Dylancouzon/l6-robot/docs/README.md

# Documentation

Choose the shortest guide that matches what you are trying to do.

## First Steps

The printable enclosure does not include the electronics. If you want to build the complete robot, check the hardware requirements before you print anything.

| Guide | Use It When |
|---|---|
| [Get Started](getting-started.md) | You want to run the software with a computer and webcam. |
| [Hardware](hardware-parts.md) | You need the parts and material requirements for the Jetson robot. |
| [Build Your Own Robot](build.md) | You want the complete Jetson, enclosure, phone, and headless setup. |
| [Understand the Architecture](architecture.md) | You finished the course and want to follow the implementation. |

## Focused Guides

| Guide | Covers |
|---|---|
| [Print and Assemble the Enclosure](hardware.md) | Camera fit, print settings, and assembly. |
| [Calibrate the Camera](calibration.md) | Recognition thresholds, detection settings, and command-line options. |
| [Use a Phone](phone.md) | Network access, microphone permissions, and the HTTPS certificate. |
| [Set Up a Headless Jetson](appliance.md) | Automatic startup, the robot's Wi-Fi network, and maintenance. |

The top-level [README](../README.md) is the project overview. Configuration values are documented beside their defaults in [`.env.example`](../.env.example).
