Dylancouzon/l6-robot/docs/hardware-parts.md

# Hardware

The printable files contain the enclosure only. To build the complete robot, gather every item in the following table before you print the enclosure.

| Item | What You Need |
|---|---|
| Computer | Jetson Orin Nano Super 8 GB developer kit with its power supply |
| Storage | 256 GB or larger M.2 2280 NVMe solid-state drive (SSD) |
| Camera | 37 × 37 mm USB Video Class (UVC) camera board with a lens near 100° |
| Interface | Phone or tablet with Wi-Fi and a microphone |
| Filament | About 300 g of PLA in three colors |
| Assembly supplies | One zip tie and a drop of glue |

You also need access to a 3D printer with a build area of at least 177 × 176 mm. The repository provides the ready-to-print files and software.

## Check Camera Compatibility

The enclosure was designed around the Arducam IMX291 (B0200). A different camera must meet all three measurements:

- Board: 37 × 37 mm and 1.4 to 1.8 mm thick, with connectors on the back.
- Lens length: no more than 27 mm from the front of the board when focused fully inward.
- Lens width: no part around the barrel wider than 26.5 mm.

Check the manufacturer's dimensions or measure the camera before printing. The glued visor makes a later camera change difficult.

After you have the parts, follow [Build Your Own Robot](build.md) for the complete setup sequence or go directly to [Print and Assemble the Enclosure](hardware.md).
