Dylancouzon/l6-robot/hardware/eye_visor.stl

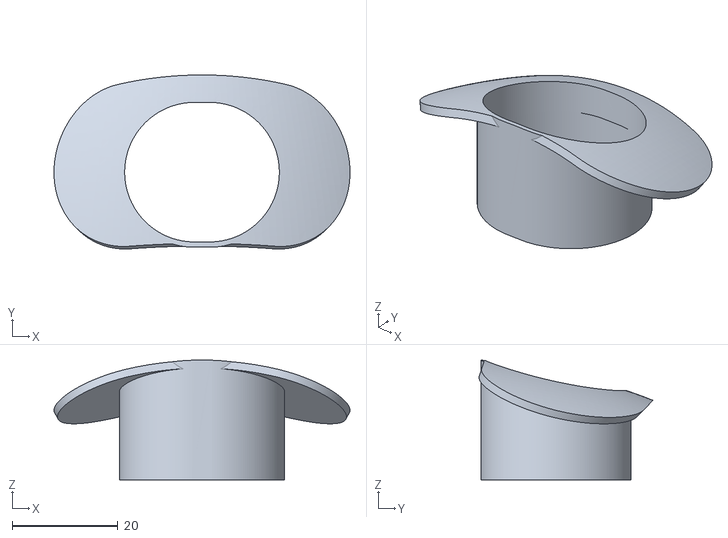
[picture p6: CAD file, 2026-08-19]
hardware/eye_visor.stl
56.0 x 32.9 x 22.7
