Dylancouzon/l6-robot/hardware/antenna_tip.stl

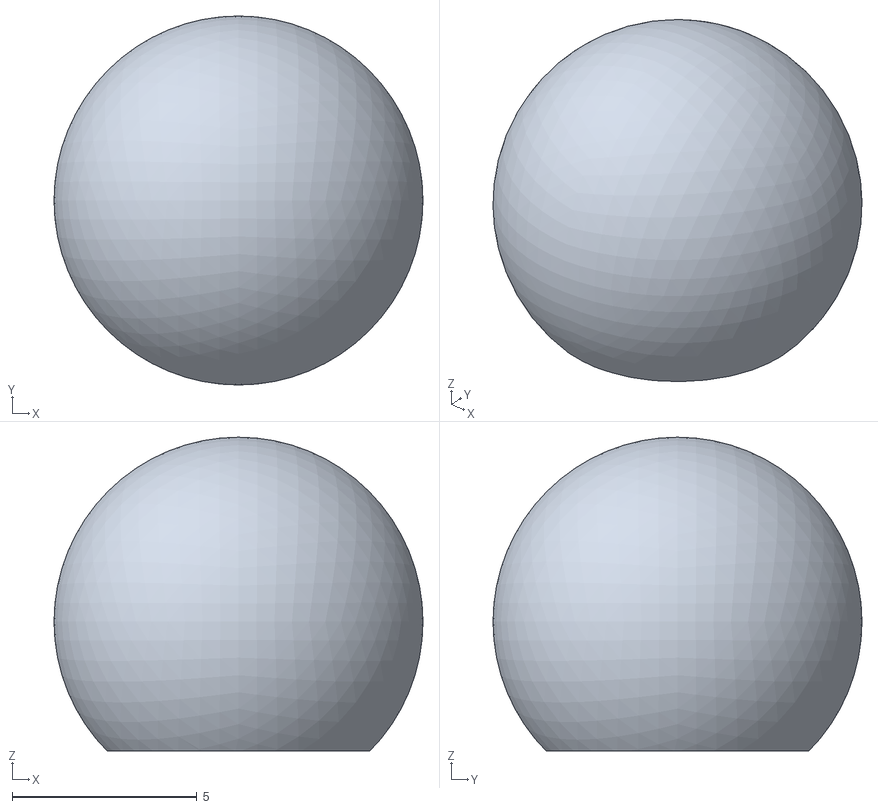
[picture p7: CAD file, 2026-08-19]
hardware/antenna_tip.stl
10.0 x 10.0 x 8.50
