Dylancouzon/l6-robot/hardware/shell.stl

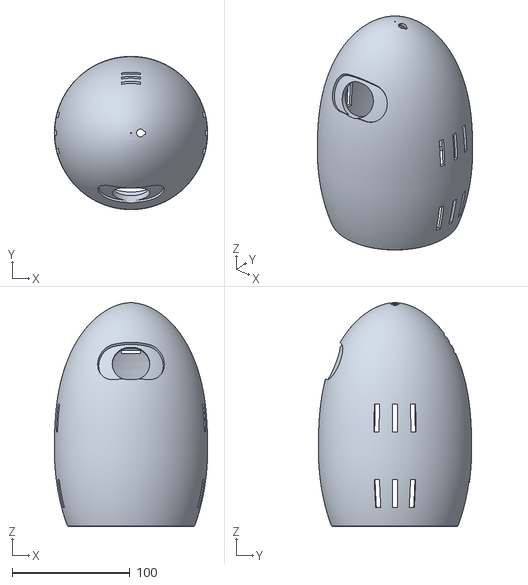
[picture p8: CAD file, 2026-08-19]
hardware/shell.stl
130.0 x 130.0 x 190.0
