Dylancouzon/l6-robot/hardware/antenna.stl

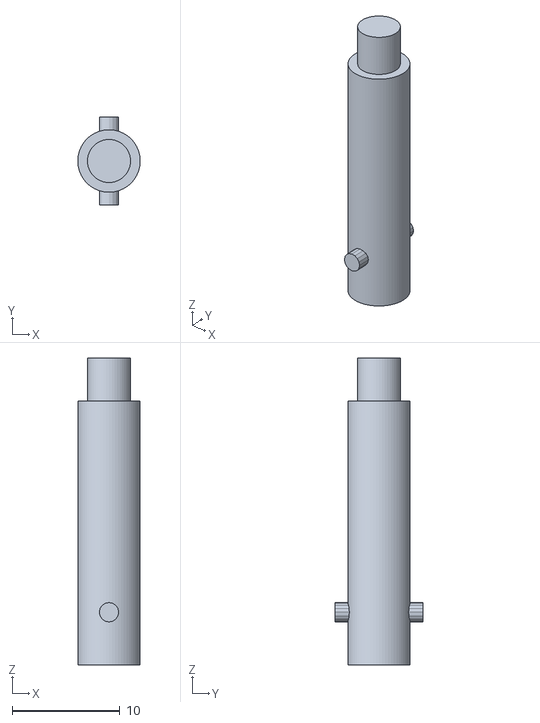
[picture p9: CAD file, 2026-08-19]
hardware/antenna.stl
5.80 x 8.20 x 28.5
