Dylancouzon/l6-robot/hardware/keel.stl

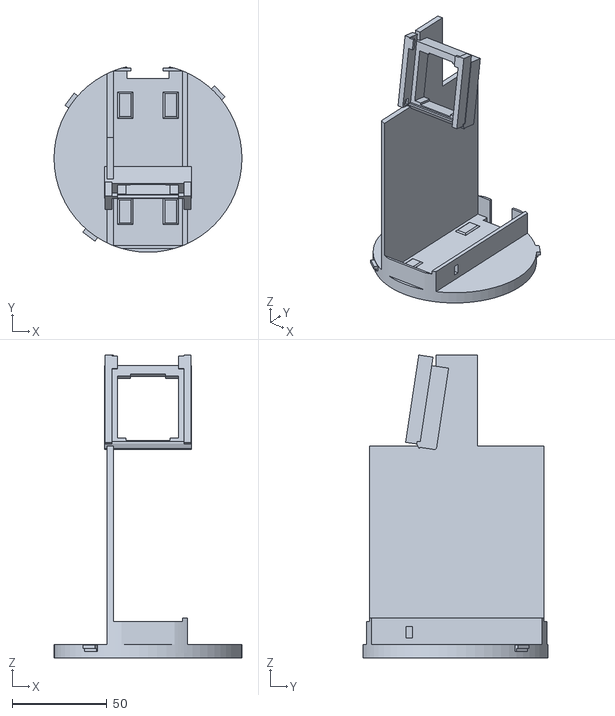
[picture p10: CAD file, 2026-08-19]
hardware/keel.stl
99.0 x 97.7 x 159.6
