Dylancouzon/l6-robot/hardware/charcoal_plate.3mf

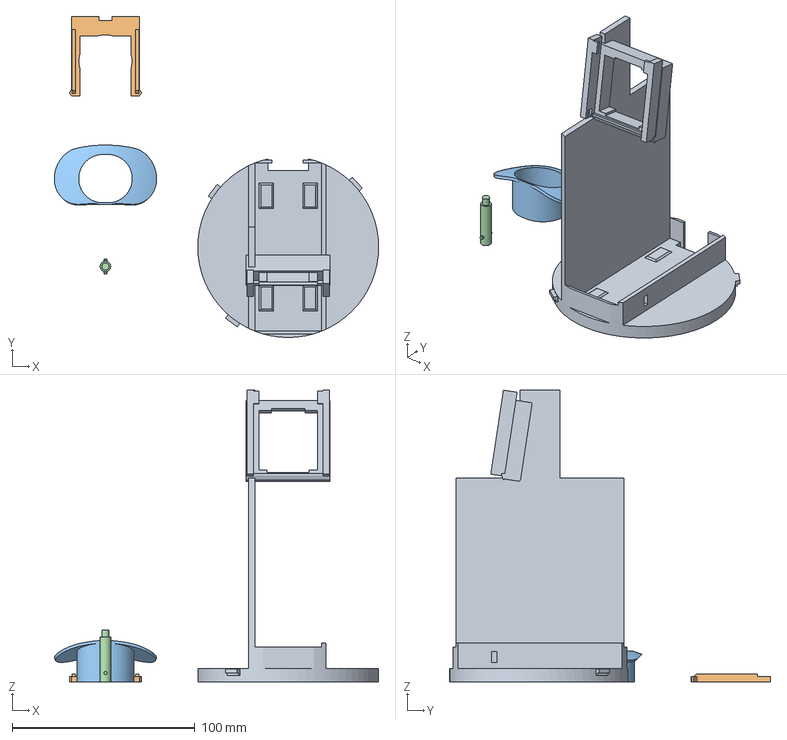
[picture p11: CAD file, 2026-08-19]
hardware/charcoal_plate.3mf
177.5 x 175.7 x 159.6 mm
l6b1_keel
l6b1_camera_clamp
l6b1_eye_visor
l6b1_antenna
