Dylancouzon/l6-robot/hardware/camera_clamp.stl

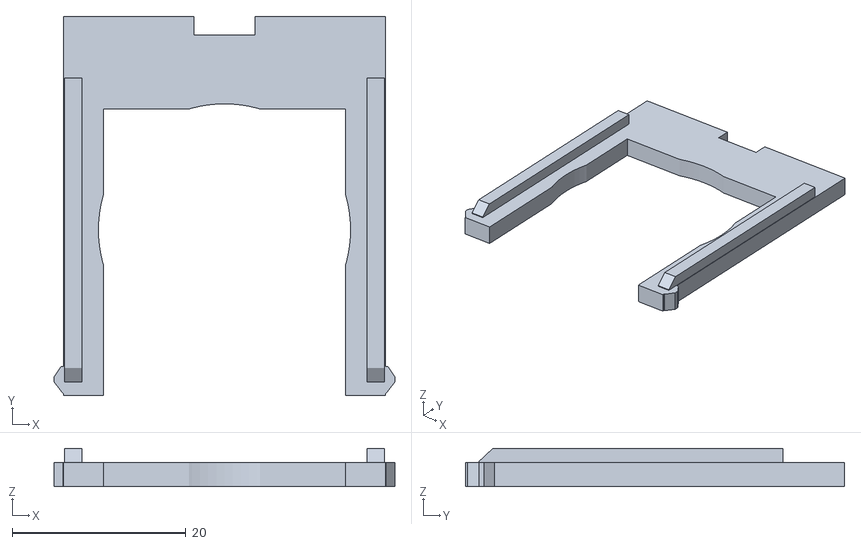
[picture p12: CAD file, 2026-08-19]
hardware/camera_clamp.stl
39.2 x 43.6 x 4.40
