Dylancouzon/l6-robot/(list of files, cad)

Other CAD files:
hardware/white_plate.3mf
hardware/red_plate.3mf
