Dylancouzon/l6-robot/testdata/hardhat_1.jpg

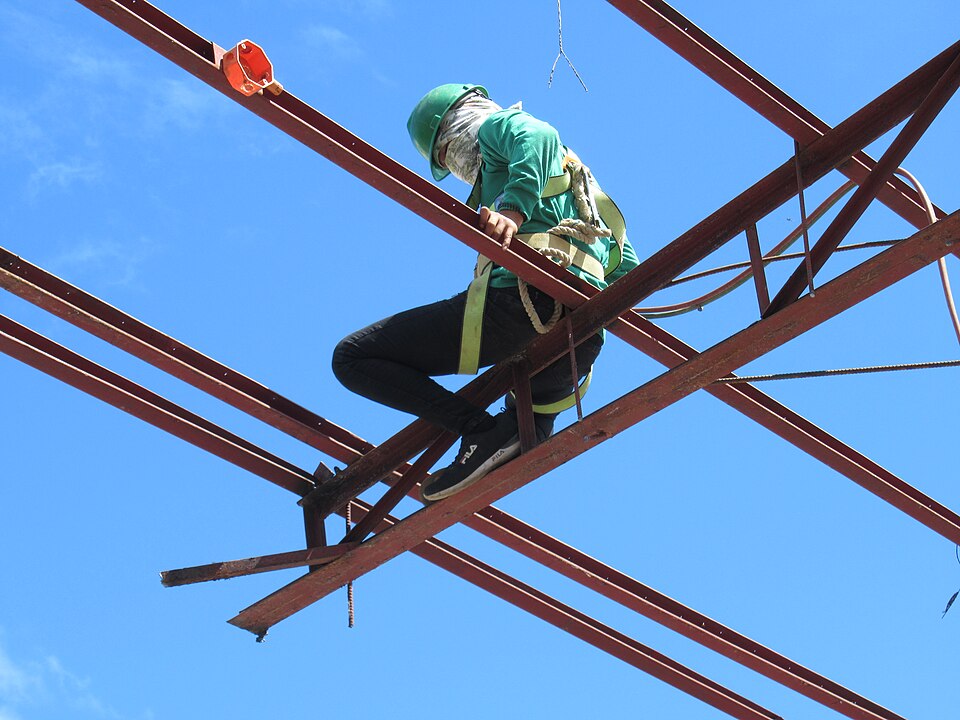
testdata/hardhat_1.jpg
