Dylancouzon/l6-robot/testdata/rubberduck_1.jpg

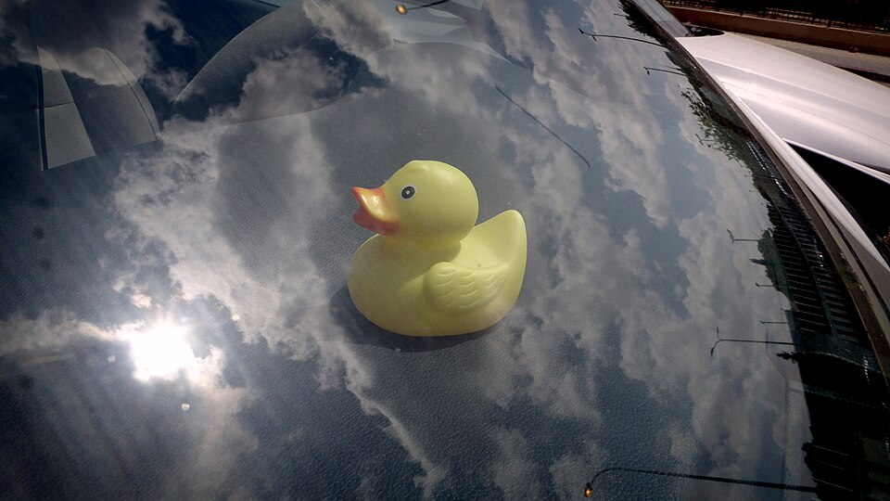
testdata/rubberduck_1.jpg
