Dylancouzon/l6-robot/testdata/rubberduck_3.jpg

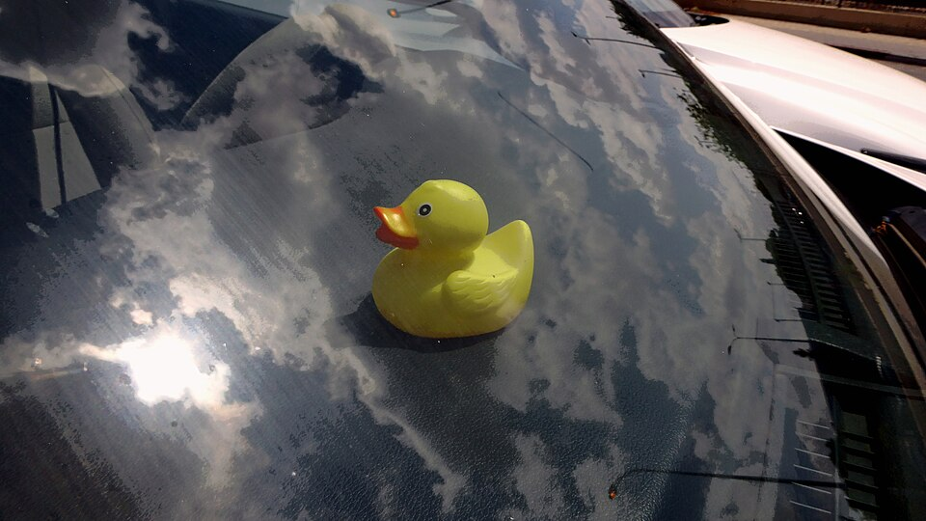
testdata/rubberduck_3.jpg
