Dylancouzon/l6-robot/testdata/vase_1.jpg

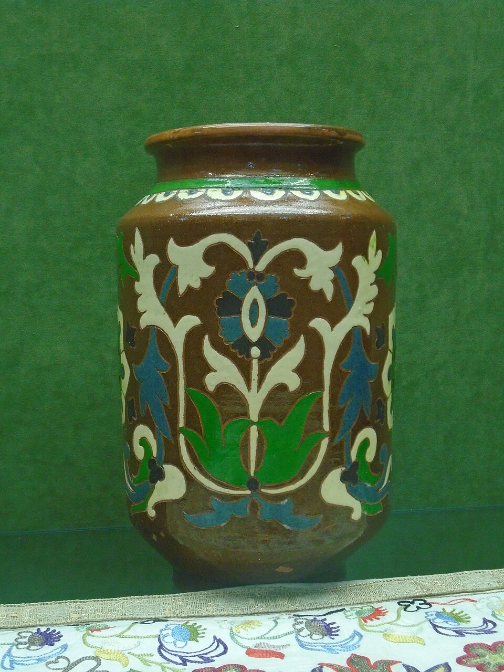
testdata/vase_1.jpg
