Dylancouzon/l6-robot/testdata/vase_2.jpg

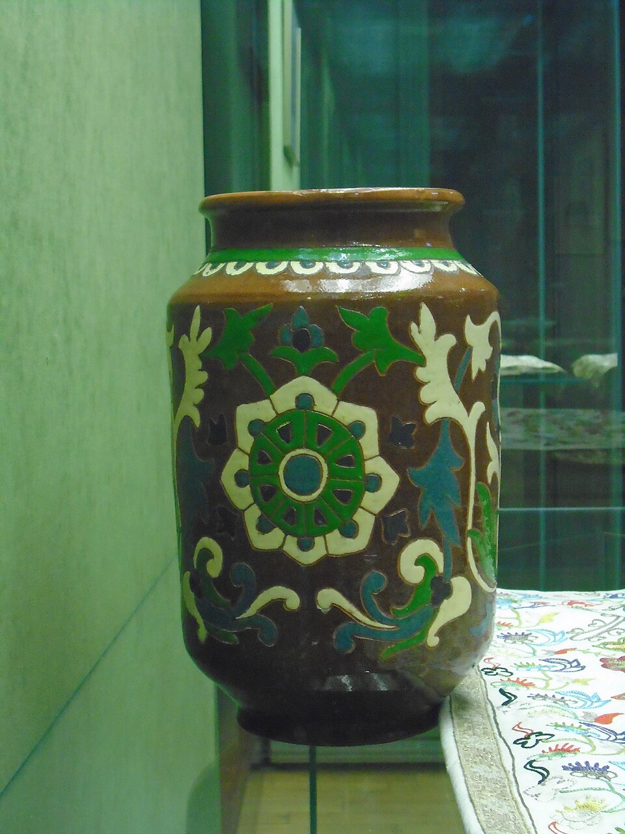
testdata/vase_2.jpg
