Dylancouzon/l6-robot/testdata/vase_3.jpg

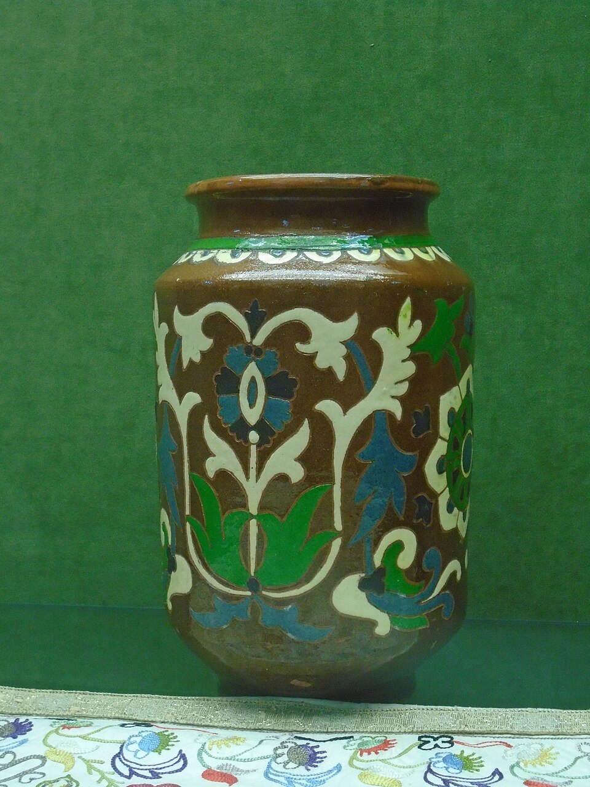
testdata/vase_3.jpg
