Dylancouzon/l6-robot/(commit log)

2026-07-16 Switch mic capture to sounddevice, splash progress
2026-07-16 Verify Edge aarch64 wheel in Jetson checklist
2026-07-16 add BOM, prep for Jetson integration
2026-07-17 Tighten BOM, improve wording
2026-07-17 BOM nits
2026-08-12 Enable CUDA detection on Jetson
2026-08-12 Load only the camera-loop encoder at startup
    The robot became unusable on a Jetson Orin Nano 8 GB, updating the view
    roughly once every 15 seconds. The cause was startup memory, not CUDA:
    warm_up() eagerly built all four ONNX encoders, and ONNX Runtime gives each
    session one spinning thread per core. That reached 3.3 GB and 78 threads
    before the camera opened, leaving ~280 MB free and pushing 2 GB of the
    process into swap, so every teach/ask paged it back in.
    Keeping Whisper resident also bought little: transcription costs ~6 s
    regardless, so residency saved ~3 s of load time for 1.7 GB.
    - warm_up() now loads only the CLIP vision encoder, the one model the camera
    loop uses per frame. The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
2026-08-12 Calibrate the recognition threshold per camera
    Teaching one object made almost everything in frame match it at 0.80-0.88,
    while the true object sat above 0.90.
    The Qdrant layer is fine: stored image vectors have L2 norm 1.0 (Qdrant
    pre-normalizes on upsert for Cosine), shard scores equal hand-computed numpy
    cosine to 1e-7, and the named vectors are correctly wired. The cause is that
    CLIP cosine similarity has a high floor -- two unrelated crops from the same
    camera routinely score 0.75-0.85 -- and the 0.80 threshold came from a harness
    that never exercised the live crop pipeline.
    verify_scores.py cropped large studio photos with no segmentation mask; the
    app masks and feeds crops as small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
2026-08-12 Take button work off the frame pump and steady the focus
    Two operator-visible symptoms on the Jetson: the feed stuttered when
    FORGET or TEACH was pressed, and the single UNKNOWN box hopped between
    objects fast enough that teaching the intended one was a race.
    The stutter was work sitting on the thread that must never block -- the
    one doing cap.read(), composing the view and encoding the streamed JPEG:
    - Key handling ran inline in _loop. FORGET scrolls up to 10k points,
    deletes and flushes; REBOOT reopens the shard. Both also waited on the
    lock the detect thread holds for a whole YOLO pass. Moved to _key_loop
    on its own thread; _loop now captures and renders and takes no lock.
    - Teach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
2026-08-12 Run headless on its own Wi-Fi, starting at boot
    The demo unit goes in a case with no keyboard, screen, or peripherals, and
    demos in rooms with no usable network. Apply power and it now boots into the
    robot on its own access point.
    `deploy/l6-robot.service` starts it at boot and restarts it on death;
    `deploy/headless-setup.sh` installs the unit, builds the NetworkManager AP
    profile, fills the model cache while there is still internet, and turns the
    desktop off (~1.5 GB on an 8 GB board). The Wi-Fi block runs last, because
    converting the radio kills any ssh session arriving over it.
    Two real bugs surfaced doing this, both fixed here rather than papered over
    in the unit:
    - FastEmbed was cach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
2026-08-12 Document how to get into the robot when it is headless
    The unit has no keyboard, screen, or peripherals, and often no network it can
    rely on, so "how do I get a shell on it" stopped being obvious.
    Three independent routes, all verified on the unit. Your LAN, with the robot
    wired to the router and you on its Wi-Fi — the best one, because the robot then
    has internet and its hotspot shares that internet with your phone. The robot's
    own hotspot, which works anywhere but has no uplink, so Claude Code will not run
    over it. And the USB-C debug port at a fixed 192.168.55.1, which needs no
    network, router, or DNS at all. The same cable carries a serial console on
    ttyGS0, so it degrades to a workin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
2026-08-12 Make the appliance's feed and voice path fit its own Wi-Fi
    Over the robot's hotspot the feed ran slow and arrived 5+ s late, every
    action seemed to freeze for seconds, and teaching by voice returned
    nonsense labels. None of it was the headless setup: measured on loopback,
    no action stalls the frame pump by more than 149 ms.
    The feed sent 60% duplicate bytes. /stream pushed on a fixed 0.04 s tick
    while the pump renders at the camera's 10 fps: 171 frames over 7 s, 69
    unique, 37 Mbps. _publish now stamps each composed JPEG and stores one
    atomic (seq, bytes) tuple; the handler sends only on a change and always
    takes the newest, so a client that falls behind loses frames instead of
    accumulating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
2026-08-12 Make the memory panel HTML so it fits a phone
    The panel was pixels drawn into the video: cv2.putText at a fixed 480 px,
    hstacked onto the feed and re-encoded ten times a second. On a phone in
    portrait the browser contains the 2.44:1 composite into ~160 pt of height,
    which renders the panel about 100 pt wide — unreadable, and unfixable by
    any amount of font tuning. Hence the "rotate to landscape" nag the page
    used to carry, which was really a bug report.
    /stream now carries the annotated feed alone and the page polls /state
    (JSON, 4 Hz), rendering the panel as DOM: it lays out for the screen it
    lands on, in portrait as well as landscape. Two small endpoints support
    it — /thumb?f=NAME for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
2026-08-12 Keep a track alive through a dropout, and hold focus steadier
    Recognized objects came and went on a static scene, and teaching seemed to
    freeze. Neither was the recognition threshold and neither was new.
    The cause was DEAD_SECONDS = 1.5. A real object's detector confidence swings
    across DETECT_CONF: the microphone measured 0.34-0.91, and absent altogether on
    some frames, so dropouts past a second are routine. At 1.5 s the Track was
    destroyed, taking label, note, thumb, vec and last_query with it, and the object
    came back a stranger -- nothing on screen for STABLE_FRAMES passes, then a fresh
    embed, then green again. The shard counted it: 866 sighting thumbs, and in one
    25-minute window 57 Tr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
2026-08-12 Cut first-teach latency, unify label casing, re-arm the swap backstop
    Review round on "teach is slow to register, recognition okay but not
    great", measured on the live box and shard before anything moved:
    - Teach's steady 6 s is whisper-base on CPU — the floor (ORT here is the
    CPU-only build); documented, not chased. The first action of a session
    paid ~7 s of model loads after release; the phone path now warms them
    under the button hold, behind a lock, because lru_cache does not
    serialize a cache miss. The laptop path deliberately does not warm at
    press: a cold load's 1.4-1.6 s GIL holds starve record_wav's 100 ms
    reads and chop the audio (caught by adversarial review), and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
2026-08-13 Add a memory tab, and let the robot recognize people
    FORGET could not be aimed. It acted on whatever held the box at the
    instant of the press, and focus moves between deciding to press and
    pressing, so the object that got deleted was not always the one the
    operator was looking at. Deleting now happens in a MEMORY tab, where you
    pick the object off a list and see its picture first. The button took
    FORGET's slot -- still four buttons -- and the F key stays for filming.
    The tab lists every taught object with its picture, its sighting count
    and its taught views (tap the picture to walk them), pages in on scroll,
    and lists what IGNORE dismissed so it can be undone. Two edits that used
    to require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
2026-08-13 Trim the handoff notes to what a future session can act on
    The two "Verified" subsections were test transcripts -- 212 points
    renamed, a score of 0.753, `view 1 of 2` becoming `2 of 2` -- which
    record that something was checked without telling the next session
    anything it can use. Replaced with the part that is reusable: the method
    (drive the endpoints against a copy of the shard, teach without a mic
    via /listen + /audio) and the browser harness worth rebuilding, plus its
    two traps -- firefox screenshots on the load event, so hold that open or
    you photograph a half-laid-out page, and drive the probe against a stub,
    never the live service.
    Also stops describing the scene picture's whole-fram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
2026-08-13 Answer recall from the text space, add SET LOCATION, and unblock the tab
    Three rounds, all measured on the live unit before anything moved:
    - The reported "system slowed down" was the hotspot NAT-sharing Ethernet
    to a joined laptop — documentation, not code (README, twice). The review
    it prompted found the real code cost: /memories and /ignored waited
    0.8-1.6 s behind the detect thread's YOLO lock for half-millisecond
    reads. Memory now serializes its own shard access and the ignore dict is
    copy-on-write, so tab reads answer in ~5 ms with the app lock held.
    - SET LOCATION in the memory tab edits the place stamped on new memories
    (POST /where, persisted in edge-data/where.txt a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
2026-08-13 Persist IGNORE by appearance, show sightings in the tab, document the mic prompt
    Three phone reports. Ignored objects died with the session because only a
    track id was stored, and ids restart every run — a dismissal is now a
    kind="ignored" point (vector + picture) in the shard, and an unknown whose
    requery matches no taught view is re-suppressed against those points at the
    same 0.90 bar. Taught always beats ignored, so a degenerate ignored crop can
    at worst hide unknown clutter; the tab lists every dismissal with TRACK
    AGAIN, which deletes the point and lifts its live blocks (pids travel as
    strings — the 2^53 trap). The memory tab's card now tap-cycles taught views
    then recent sightings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
2026-08-13 Show the maybe band in orange, and route the iOS cert install through Safari
    A nearest-taught score within 0.05 under the bar now draws an orange box
    and panel state saying "hat? 0.87" instead of a bare UNKNOWN. Display only,
    deliberately: a guessed track is still unlabeled — still the teach target,
    writes no sighting, can't be forgotten, still checked against the ignore
    list — so the measured refusal to act at 0.88 stands. A hat in orange says
    "teach this angle"; a mirror in orange shows what the bar keeps out.
    The every-press mic prompt was Chrome on iOS with the cert untrusted:
    Chrome can't install profiles, so the README now says to download
    /cert.crt in Safari, after which the trus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
2026-08-13 One count over the card cycle, tap-to-confirm on a guess, DROP on sightings
    Three same-day reports from driving the maybe band and the sightings cycle.
    The card caption runs one combined count ("3 of 10 · seen") instead of two
    lists inside one cycle. Tapping the orange "dylan?" panel label now teaches
    that crop under that name — the page sends the label it displayed and the
    server re-verifies it against the live guess before acting (the FORGET
    lesson), then labels the track in place so the box turns teal on the tap
    and a double-tap is a no-op; encoders warm outside the lock like the voice
    path. DROP THIS VIEW works on sightings too, through the same verified
    door: taught ids first (last-v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
2026-08-13 Drop a sighting's whole burst, so the delete is visible
    "Dropping a view doesn't work. Stays at the same count" — the delete
    worked, invisibly. The tab and recall show burst-collapsed rows (one photo
    stands for every sighting within SIGHTING_APART of it), so deleting only
    the shown point promoted a near-identical frame from the same burst into
    the same slot: measured on a live-shard copy, hat's dropped row came back
    151 s older and looked identical. The unit of deletion is now the unit of
    display: forget_sighting_burst deletes the shown row's burst, bounded by
    the point's own label so a stale page can never delete another object's
    photos. Same scenario now removes 4 photos and surfaces an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
2026-08-13 Uncap the card's occasion list, so the counter shrinks when you drop
    The sightings list was capped at the newest 8 occasions, and an object
    with more than 8 made DROP look broken all over again: drop one of 40 and
    the 9th slides into the slot — the counter never moves. Operator caught it
    on hat within a day of the burst fix. The list is what DROP works through,
    so it now shows every distinct occasion; the counter is real and shrinks
    on every drop. Cheap on real data: the whole live shard puts 66 occasion
    rows in one /memories page, and pictures load only when shown.
2026-08-13 Name Whisper's language, and stop drawing a dismissed object
    Teaching was slow for a reason this file had twice ruled out. onnx-asr's
    Whisper here is the beam-search export — one graph holding the encoder and
    the decoder — and letting it detect the language runs that whole graph a
    second time. Naming it halves every teach and every ask, byte-identical
    transcript; it also stops the mis-detection that stored an English teach as
    "делан". Whisper gets its own thread count too: it is the only model a human
    waits on and it never runs beside another. Measured through the live app,
    release to answer, warm session: ~6 s before, 2.82 s with the language named,
    1.90 s at four threads — and t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
2026-08-13 Cut CLAUDE.md from 2155 lines to 671
    It was organized as sixteen rounds of narrative, newest last, which meant
    every session read the story of how each bug was found in order to reach the
    fact it left behind. This keeps the facts and drops the stories: the
    constraints, the constants and what each one decides, the traps that would
    otherwise be reintroduced, the measurements worth trusting, and the questions
    already settled. Reorganized by subsystem — recognition, detection, voice,
    memory, threads and the page, the appliance — so a session touching one area
    reads that area.
    Nothing load-bearing is gone. Every refused change keeps its measurement (0.88
    above all), every trap keeps the reas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
2026-08-19 Add hardware
    [l6b1_antenna.stl, l6b1_antenna_tip.stl, l6b1_camera_clamp.stl, l6b1_charcoal_plate.3mf, l6b1_eye_visor.stl, l6b1_keel.stl, l6b1_red_plate.3mf, l6b1_shell.stl]
2026-08-19 Reorganize into brain and device, tighten docs
2026-08-20 Half-turn every camera frame, because the chassis mounts it upside down
    CAMERA_ROTATE in .env, applied in LiveApp._loop right after cap.read(). That
    is the one place the camera enters the app, so the detector, the crops that get
    embedded, the scene pictures and the streamed view all agree about which way is
    up; rotating any deeper would let the feed and the memories disagree. 0.77 ms
    median on a 1280x720 frame against a 103 ms cap.read().
    Default 0, since a student's camera sits the right way up. The unit's own .env
    says 180. Only those two values are accepted and anything else exits at
    startup: a quarter turn swaps the frame's width and height, which the capture
    size, the page's video box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
2026-08-20 Crop the lens rim off every camera frame
2026-08-24 Run the detector at half precision on CUDA
    quantize_for(device) returns 16 on CUDA and None everywhere else, and both
    model calls in Detector ask it -- the warm-up predict as well as the track
    pass, so the first real frame is not the one that pays for a different
    precision. 167.7 -> 104.4 ms per tracked frame, p90 170.1 -> 105.8, whole
    detect pass 178.1 -> 112, CUDA peak 346 -> 181 MB. Measured over 70 frames of
    one fixed capture, so re-measure the same way rather than against a live scene.
    The detections do not move: same proposal count and the same stable tracks on
    every frame, boxes matching the fp32 run at median IoU 0.995. The scores do,
    in the third decimal, because a box shifted by h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
2026-09-01 rename print files
    [antenna.stl, antenna_tip.stl, camera_clamp.stl, charcoal_plate.3mf, eye_visor.stl, keel.stl, red_plate.3mf, shell.stl]
